kaza007/sata-3.3v-injector/images/3D_PCB1_2025-02-07-back.png

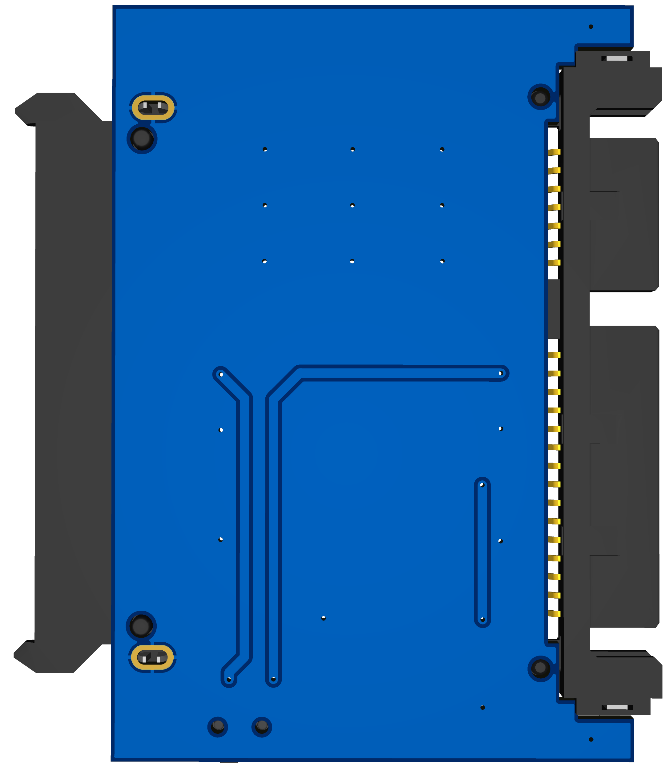
images/3D_PCB1_2025-02-07-back.png
