kaza007/sata-3.3v-injector/regulator-circuit.png

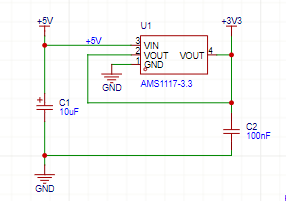
regulator-circuit.png
