kaza007/sata-3.3v-injector/manufacturing/BOM_fixed.xlsx

Comment | Designator | Footprint | JLCPCB Part # | Supplier | JLCPCB Stock
10uF | C1 | CAP-SMD_L3.2-W1.6-RD-C7171 | C7171 | LCSC | 1982907
100nF | C2 | C1206 | C882571 | LCSC | 235
HDGCYLSY-SATA-116 | J1 | CONN-SMD_HDGCYLSY-SATA-116 | C22438718 | My Parts | 0
HDGCYLSY-SATA-110 | J2 | CONN-TH_HDGCYLSY-SATA-110 | C22438712 | My Parts | 0
SK-3296S-01-L1 | SW1 | SW-SMD_3P-P1.50_L2.7-W6.6 | C319020 | LCSC | 21248
AMS1117-3.3 | U1 | SOT-223-3_L6.5-W3.4-P2.30-LS7.0-BR | C6186 | LCSC | 914295
