kaza007/sata-3.3v-injector/images/schematic.pdf

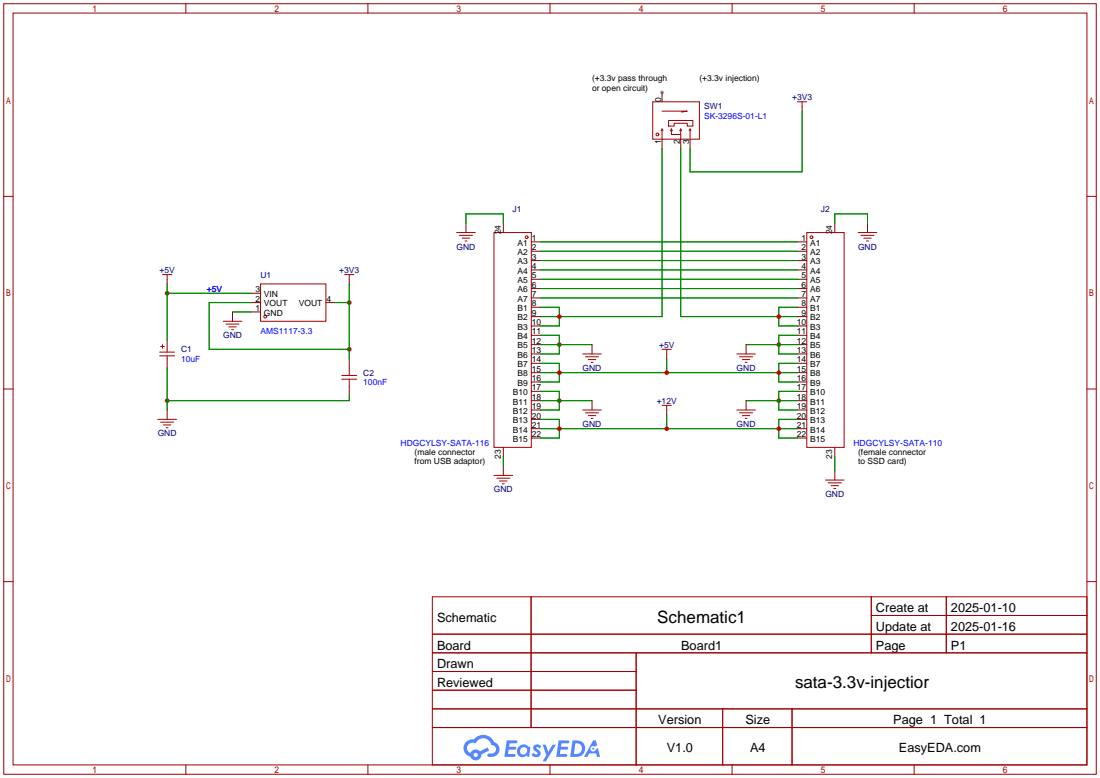
[picture p11: page 1]

Schematic | Schematic1 | Create at | 2025-01-10

Update at | 2025-01-16

Board | Board1 | Page | P1
Drawn | | sata-3.3v-injectior
Reviewed

Version | Size | Page 1 Total 1
V1.0 | A4 | EasyEDA.com
