kaza007/sata-3.3v-injector/images/PCB.pdf

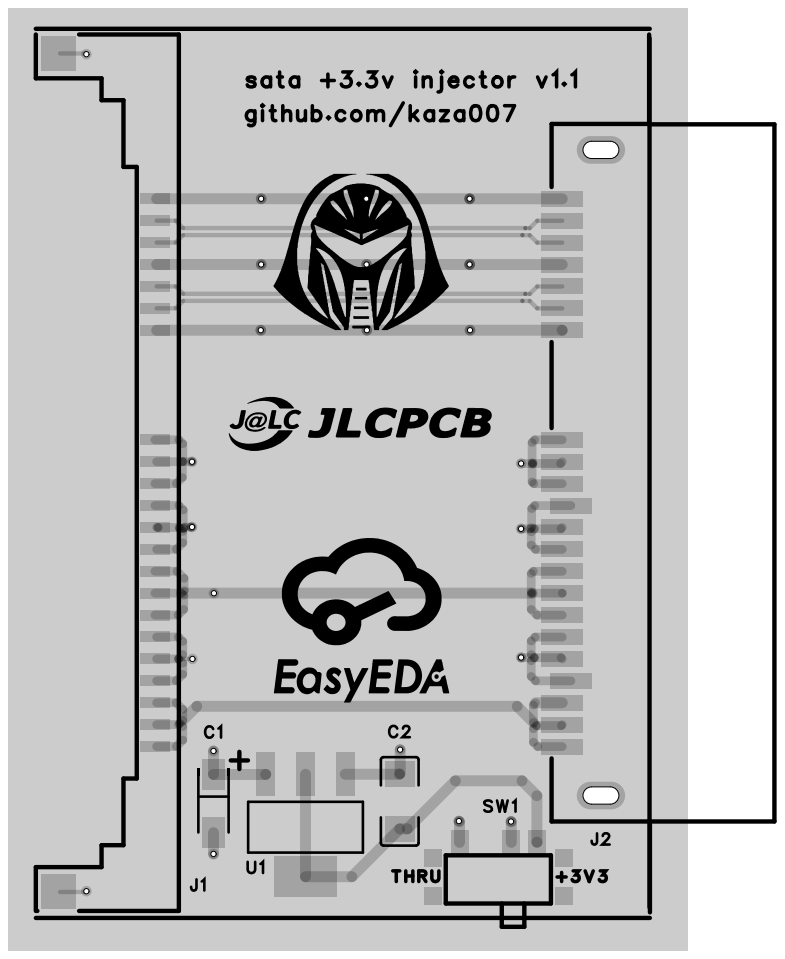
[picture p12: page 1]

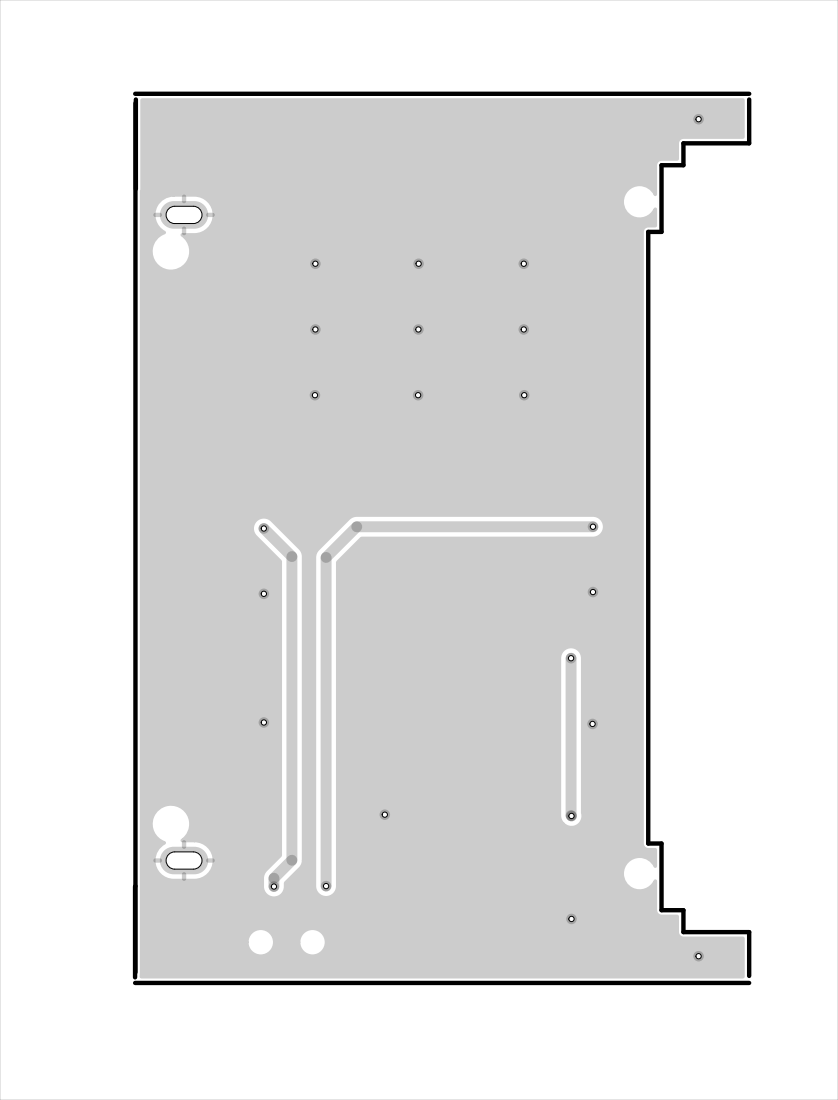
[picture p13: page 2]

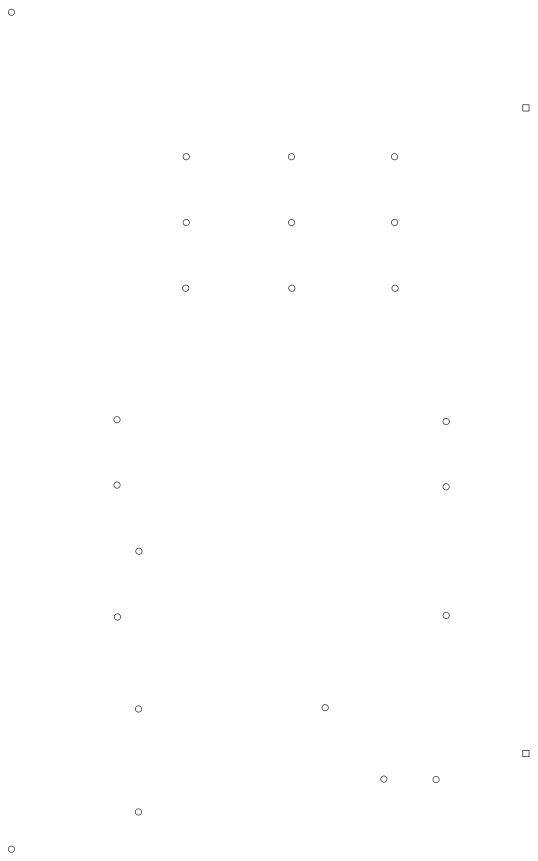
[picture p14: page 3]
