kaza007/sata-3.3v-injector/(list of files, drawings)

Other design files:
easyeda/sata-3.3v-injectior.eprj
easyeda/sata-3.3v-injector.eprj
