kaza007/sata-3.3v-injector/(commit log)

2025-02-10 add regulator circuit
2025-02-10 add usb-sata adaptor cable
2025-02-11 Rename Screenshot 2025-02-07 075157.png to pcb-top.png
2025-02-11 Rename Screenshot 2025-02-07 075225.png to pcb-bottom.png
2025-02-11 add easyeda project file
    [sata-3.3v-injectior.eprj]
2025-02-11 added schematic image
2025-02-11 added manufacturing files v1.0
    [BOM_fixed.xlsx, PickAndPlace_PCB1_2025-01-16.xlsx]
